Simion1z1/Sorting-robot/presentations/Presentation-Simple.pptx

ROBOTICS PROJECT

The robot that sorts boxes by their QR code

How it picks up a box, reads its code and places it on the right shelf by itself — explained simply, step by step.

QR Sorting Robot • Cartesian XYZ gantry + ESP32 • PC-decode pipeline

## Slide 2

What does the robot do?

A miniature automated warehouse: pick & place with sorting by code

• Boxes arrive, each with a QR code stuck on it
• The code says WHERE the box must go (e.g. MS0011, CJ0012)
• The robot picks up the box and reads its code with a camera
• It decides by itself which shelf it belongs to and places it there
• It returns and waits for the next box — fully automatic

## Slide 3

In short: 5 steps

1

PICK the box
from the feed zone

2

BRING the box
to the camera

3

READ
the QR code

4

DECIDE
the right shelf

5

PLACE the box
and return

## Slide 4

How the robot moves

A Cartesian XYZ frame (gantry), not an articulated arm

• It has 3 axes sliding on straight rails: X, Y and Z
– X = left/right, Y = front/back, Z = up/down
• Combining the 3, the tip reaches any point (like a 3D map)
• Same principle as a 3D printer or a CNC machine
• Stepper motors: they turn in equal steps → very precise positioning

## Slide 5

How the robot “sees” the QR code

A QR code = a “2D barcode” that hides a piece of text

• On its tip it carries a small camera (ESP32-CAM)
• The camera STREAMS the video over WiFi to a PC
• On the PC, a Python program (OpenCV) decodes the code into text
– Why on the PC? It is far more accurate than decoding on the tiny chip
• The camera is always brought to the same spot so it stays in focus

## Slide 6

The three actors of the system

THE EYE — ESP32-CAM
Sits on the tip. Streams the video over WiFi. Decodes nothing, moves nothing.

THE PC
Receives the video, decodes the QR with OpenCV, sends the code to the brain.

THE BRAIN — ESP32
Gets the code, drives the motors and the hand, decides the shelf.

Data flows one way: camera → (WiFi video) → PC → (USB cable, “QR:CJ0012”) → brain.

## Slide 7

How it decides where to put the box

Fixed code → cell mapping: simple and safe

• The shelves are a grid of 3 rows × 2 columns
• Each code has a fixed cell, set in advance:
– MS0011 → row 1 left, CJ0012 → row 2 right, etc.
• The robot looks the code up in a table and goes exactly there
• Unknown code? It rejects it — it will not risk a mistake

## Slide 8

Why ESP32 and not classic Arduino?

ESP32 = a small, cheap and powerful “mini-computer”

• It has WiFi/radio built in → needed for the wireless video
• It has far more memory → it can handle the camera image
• It has 2 cores → it moves the motors AND communicates at the same time
• It generates the motor pulses with dedicated hardware (precise)
• An Arduino Uno (2KB memory, no radio) simply could not

## Slide 9

Safety: how it does NOT hit the shelves

Simple rules that prevent collisions

• It ALWAYS raises the arm (Z) before moving sideways
• On power-up it does “homing”: it finds the zero point by itself
• It has software limits — it cannot leave the working area
• A STOP command that halts everything instantly

## Slide 10

In short — what we built

Thank you! Questions?

• An XYZ robot that sorts boxes fully automatically, by QR code
• Two ESP32 boards: one “sees”, one “drives”
• A PC decodes the code for high accuracy
• Precise motors + camera + a hand that grabs the box
• Every decision was made for reliability and simplicity
