Simion1z1/Sorting-robot/presentations/Presentation-Technical.pptx

TECHNICAL DOCUMENTATION

QR Sorting Robot — Cartesian XYZ gantry

Architecture, motion control, vision, the PC-decode pipeline, the sorting logic and the design decisions.

QR Sorting Robot • Cartesian XYZ gantry + ESP32 • PC-decode pipeline

## Slide 2

Table of contents

• 1. System architecture (two MCUs + a PC)
• 2. Mechanics: XYZ gantry + screw actuators
• 3. Motion control: steppers, A4988, FastAccelStepper
• 4. Coordinates, homing, software limits
• 5. Gripper (SG90 / LEDC PWM)
• 6. Vision: PC-decode pipeline (ESP32-CAM stream + OpenCV)
• 7. Communication (WiFi stream + USB serial)
• 8. Sorting logic (CODE_MAP) + state machine
• 9. Power & pin map
• 10. Design decisions & lessons

## Slide 3

System architecture

1

## Slide 4

Two microcontrollers + a PC, separate responsibilities

ESP32-CAM — VISION
OV2640 + PSRAM. Streams MJPEG over WiFi (esp32cam_stream). Decodes nothing, controls nothing mechanical. Rides on the Z carriage.

PC — DECODER
decode_qr.py: reads the MJPEG stream, decodes the QR with OpenCV/pyzbar, forwards “QR:<code>” over USB serial.

ESP32 WROOM-32D — BRAIN
State machine (brainPC). STEP/DIR for 3× A4988, homing on endstops, servo, receives QR over serial, decides the cell.

Why the split?
The camera takes up nearly all ESP32-CAM pins, and reliable QR decoding is heavy. The motion loop is timing-critical and must never be blocked. → camera streams, PC decodes (accurately), brain moves.

## Slide 5

Why ESP32 (not AVR/Arduino Uno)

• Built-in radio (WiFi) — mandatory for the wireless video stream
• Dual-core 240 MHz — motion on one core, comms on the other
• ~520 KB RAM (+PSRAM on the CAM) — impossible with 2 KB on an ATmega328
• Hardware peripherals: RMT (step pulses) and LEDC (servo PWM)
• 3.3 V logic — directly compatible with the ESP32-CAM, no level-shifter
– Programmed entirely from the Arduino IDE (C/C++) — same ecosystem

## Slide 6

Mechanics — XYZ gantry

2

## Slide 7

Cartesian frame with screw actuators

Advantage: precision and repeatability (like a 3D printer / CNC)

• 3 orthogonal axes: X (left/right), Y (front/back), Z (up/down)
• Each axis = screw actuator (lead/ballscrew) + NEMA 17
• Screw rotation → translation of the nut/carriage (linear motion)
– Screw lead = 4 mm per turn
• On the Z carriage: the gripper + ESP32-CAM (load below the Z motor torque)
• Typical build order: Y base → X bridge → Z vertical

## Slide 8

Motion control

3

## Slide 9

Stepper motors + A4988 drivers

• NEMA 17, 1.8°/step → 200 steps per full revolution
• Open-loop control: count the steps ⇒ you know the position
• The ESP32 cannot power the motor → the A4988 driver amplifies
– The brain only sends: STEP (pulse = 1 step) and DIR (direction)
– Shared ENABLE (GPIO13, active-LOW) for all 3 drivers
• Runs on full step; MS1/2/3 set by jumpers, not on GPIO

## Slide 10

Calibration: steps per millimeter

steps_per_mm = (steps/turn × microstepping) / screw_lead
= (200 × 1) / 4 mm = 50 steps/mm

• Verified empirically: command 100 mm → measure with calipers → 100 mm ⇒ steps_per_mm = 50.0
• FastAccelStepper: timing on the RMT hardware → no lost steps at high speed
• 3 motors at once, smooth acceleration/deceleration, without loading the CPU
• Motion profile: V (mm/s) and A (mm/s²) adjustable from commands

## Slide 11

Coordinates & homing

4

## Slide 12

Homing — establishing the origin

• At power-on the physical position is unknown → need a reference zero
• 6 endstops (MIN + MAX per axis), wired NO + INPUT_PULLUP
– Pressed = LOW (NC would be fail-safe, but the NC terminal did not work)
• Per-axis sequence: fast approach → back-off ~4 mm → slow re-approach → 0
• Order Z → X → Y (anti-collision: raise Z first)
• Z homes UP (toward MAX): the shelves are in front
– Consequence: Z=0 is at the top (safe); going down toward shelves = negative

## Slide 13

Software limits (soft limits)

Axis | Min (mm) | Max (mm) | Note
X | 0 | 194 | homes at MIN, positive travel
Y | 0 | 170 | homes at MIN, positive travel
Z | −117 | 0 | homes at MAX (top); down = negative

Safe travel
Travel height is Z = −5 mm (not 0): exactly at Z=0 the MAX switch is pressed. Before any X/Y move, Z is raised to −5 mm.

## Slide 14

Gripper

5

## Slide 15

The hand that grabs the box (SG90)

• Parallel gripper with 2 jaws, driven by an SG90 servo
• Servo = you command an angle (0–180°), it goes exactly there
• 50 Hz PWM signal on GPIO19, generated by the ESP32 LEDC peripheral
– Open = 3°, closed = 47° (at 50° it strains and buzzes)
• Needs solid dedicated 5V: at 4.5V it only “ticked”, looked broken
– Code robust to ESP32 core 2.x vs 3.x (ledcWrite/ledcAttach differ)

## Slide 16

Vision — reading the QR

6

## Slide 17

PC-decode pipeline

• The OV2640 camera captures the image (SVGA 800×600)
• ESP32-CAM serves an MJPEG stream over WiFi at http://<ip>/stream
• The PC opens the stream (OpenCV) and decodes the QR per frame
– pyzbar first, then OpenCV QRCodeDetector as fallback; errors caught
• Fixed focus (~10–20 cm): the camera is always brought to SCAN_POS
• On a hit, the PC sends “QR:<code>” to the brain over USB serial

## Slide 18

Why decode on the PC (not on the camera)

On-device problem (abandoned)
On-board decoding (quirc on the ESP32-CAM) gave a read rate often under 10%: fixed-focus OV2640 + a weak chip for image processing.

PC-decode solution
The camera only streams MJPEG; the PC decodes with OpenCV/pyzbar (far more accurate) and forwards the code to the brain. Plus a live debug window.

• esp32cam_stream.ino — MJPEG server on the camera (WiFi)
• pc/decode_qr.py — reads the stream, decodes, sends “QR:<code>” + forwards commands
• brainPC.ino — routes lines starting with “QR:” into the sort logic
• The earlier ESP-NOW on-device variant stays as a standalone fallback

## Slide 19

Communication

7

## Slide 20

Two links: camera → PC → brain

Link 1 — WiFi (MJPEG video)
ESP32-CAM joins the WiFi, runs a small web server, serves a continuous JPEG stream at /stream. The PC reads it with cv2.VideoCapture(url).

Link 2 — USB serial
The PC sends “QR:<code>” to the brain; the same cable carries the brain's logs back and the commands you type (HA, R1, P...).

• brainPC.ino: a line starting “QR:” → sort logic; otherwise → console command
• decode_qr.py auto-reconnects if the stream drops
• Anti-spam cooldown so the same code is not re-sent too fast
• The camera (streamer) needs only power — no data wire to the moving carriage

## Slide 21

Sorting & state machine

8

## Slide 22

3×2 shelves and the fixed code → cell mapping

| Column 1 | Column 2
Row 1 | MS0011 | MS0012
Row 2 | CJ0011 | CJ0012
Row 3 | EB0011 | Boxes (pickup)

• CODE_MAP: fixed table code → (row, column)
– Strategy A (fixed mapping), not “first free”
– Small, fixed set ⇒ deterministic, easy to debug
• Each cell: (x,y,z) taught manually (teach)
– Positions hardcoded in the sketch (no NVS)
• Unknown code → rejected (no move)

## Slide 23

State machine (the AUTO cycle, R1)

HOMING
Z→X→Y

GO TO
SCAN_POS

WAIT
for QR

VALIDATE
known code?

PICK
from Boxes

PLACE
at cell

RETURN
to SCAN

• Z always raised before any X/Y move (anti-collision)
• Unknown/missing code → rejected, the cycle does not get stuck
• 5 s cooldown after each sort so repeated detections do not loop the cycle
• STOP (S or R0) instantly halts motion and auto mode

## Slide 24

Power & pins

9

## Slide 25

Power distribution

• 12V → the 3 A4988 drivers (VMOT) + 100µF capacitor/driver
• Buck 12V→3.3V → ESP32 brain + driver logic
• Dedicated 5V → SG90 servo (+ cap, anti voltage-sag)
• ESP32-CAM: powered separately over USB 5V (laptop/power bank)
• COMMON GND mandatory between supply, bucks, brain, drivers, servo
– The camera (WiFi) does NOT need a common GND with the brain

Separate domains
12V power (motors) and 3.3V logic are different domains, tied only by the common GND. Capacitors absorb current spikes and prevent brownout/reset.

## Slide 26

Pin map (brain ESP32 WROOM-32D)

Function | GPIO | Notes
X STEP / DIR | 25 / 26 | pulses + direction, motor X
Y STEP / DIR | 32 / 33 | motor Y
Z STEP / DIR | 27 / 14 | motor Z
ENABLE (all 3) | 13 | active-LOW, shared
Endstop MIN X/Y/Z | 21 / 22 / 23 | INPUT_PULLUP, pressed=LOW
Endstop MAX X/Y/Z | 4 / 18 / 17 | INPUT_PULLUP
SG90 servo | 19 | PWM LEDC 50 Hz
QR input | USB serial | “QR:<code>” from the PC decoder

## Slide 27

Decisions & lessons

10

## Slide 28

Design decisions (and WHY)

• Two MCUs: isolate timing-critical motion from image handling
• ESP32 vs Arduino: radio + RAM + dual-core + hardware timing
• Decode on the PC: much higher QR read accuracy than on-device
• ESP-NOW on-device variant abandoned (read rate was the bottleneck)
• FastAccelStepper: no lost steps at speed/microstepping
• Fixed mapping (A): deterministic on a small code set
• Z homes up: avoids collision with the shelves in front
• Hardcoded positions: simple “teach & paste” flow for a prototype

## Slide 29

Problems encountered & solutions

Problem | Cause | Solution
Servo only ticked | 4.5V supply | solid dedicated 5V + common GND
Camera kept resetting | weak USB / auto-off | good USB, 470µF cap
Low on-device QR rate | fixed focus / weak chip | moved decoding to the PC
Stream read fails | WiFi hiccup | decode_qr.py auto-reconnects
Cycle looped on one box | repeated detections | 5 s cooldown after each sort
“endstop hit” on Z | Z=0 sits on the switch | travel at Z=−5 mm

## Slide 30

Conclusions

Thank you! Questions?

• XYZ gantry + steppers/A4988, driven by an ESP32 (state machine)
• ESP32-CAM as a wireless camera; the PC is the smart decoder
• Deterministic sorting via a fixed code → cell table
• Robust architecture: vision/motion split + PC-side accuracy
• Many decisions validated hands-on at the bench (power, decoding, Z homing)
