Simion1z1/Sorting-robot/Gen Qr-codes/QR Codes.pdf

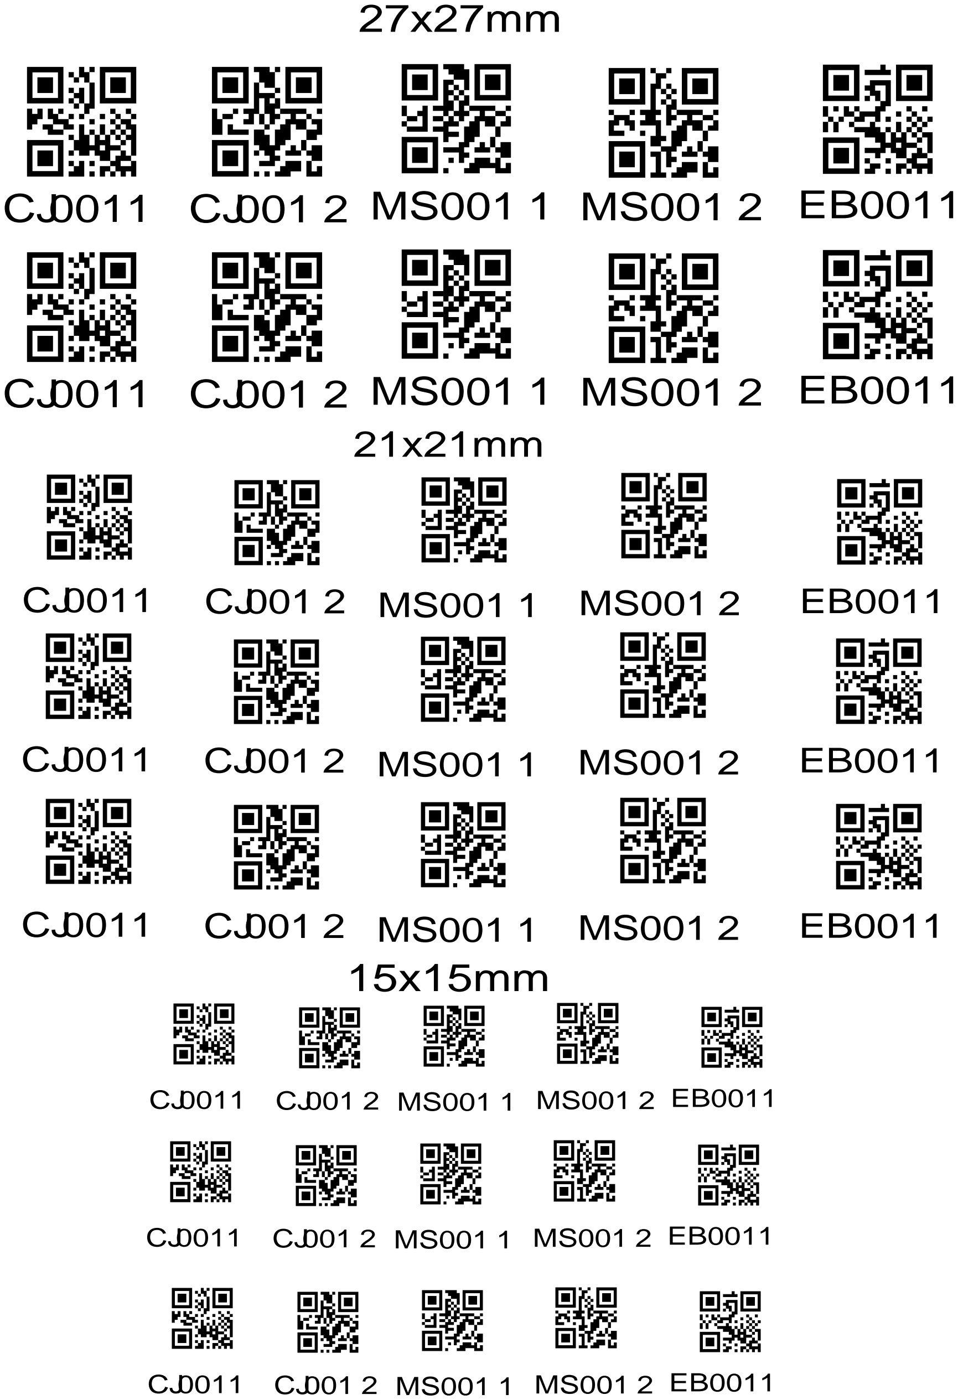
[picture p1: page 1]

CJ0011

CJ0011

CJ001 2

EB0011

CJ001 2

MS001 1

MS001 1

MS001 2

27x27mm

15x15mm

21x21mm

EB0011

CJ0011
CJ001 2

MS001 1
MS001 2

EB0011

MS001 2

CJ0011
CJ001 2
MS001 1

MS001 2

EB0011

CJ0011
CJ001 2
MS001 1

MS001 2

EB0011

CJ0011
CJ001 2
MS001 1

MS001 2

EB0011

CJ0011
CJ001 2
MS001 1

MS001 2

EB0011

CJ0011
CJ001 2
MS001 1

MS001 2

EB0011
