Simion1z1/Sorting-robot/Schematic/SCH_Sorting Robot Schematic_1-P1_2026-06-11.png

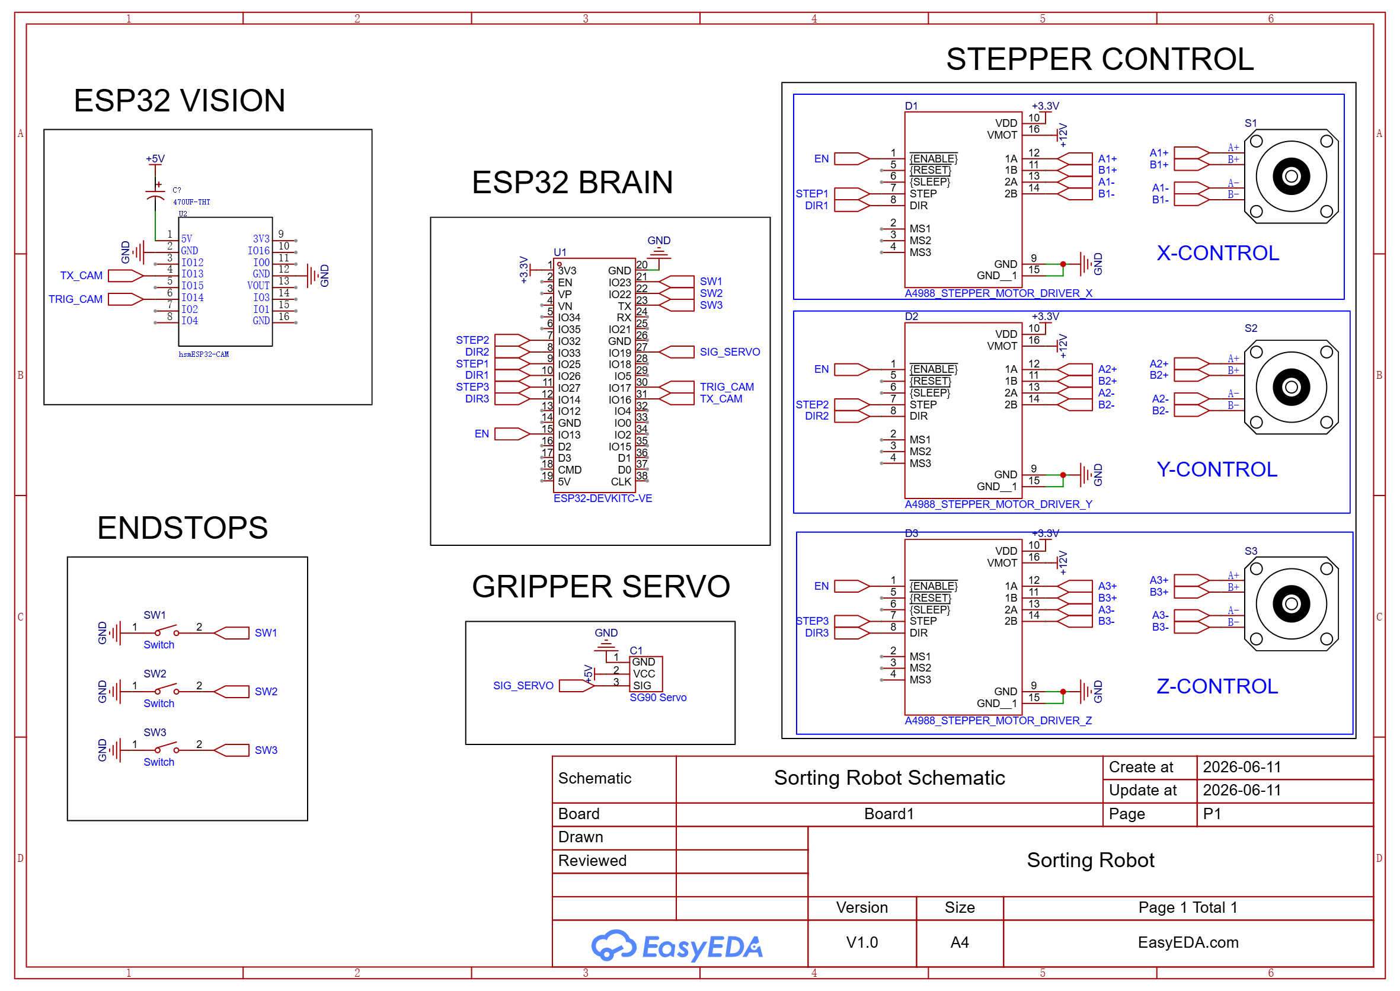
Schematic/SCH_Sorting Robot Schematic_1-P1_2026-06-11.png
