Simion1z1/Sorting-robot/SCH_Sorting Robot Schematic_2026-06-17.pdf

# STEPPER CONTROL

# ESP32 BRAIN

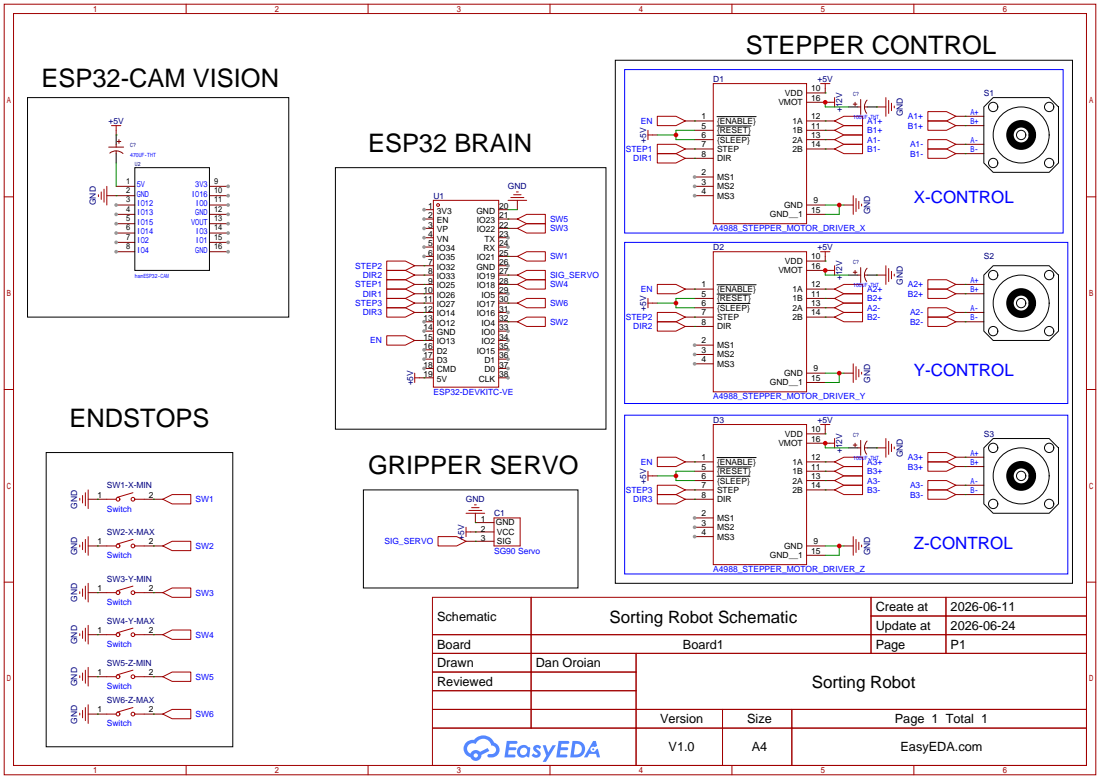
[picture p3: page 1]

GND GND GND

Schematic | Sorting Robot Schematic | Create at | 2026-06-11

Update at | 2026-06-24

Board | Board1 | Page | P1
Drawn | Dan Oroian | Sorting Robot
Reviewed

Version | Size | Page 1 Total 1
V1.0 | A4 | EasyEDA.com
