Simion1z1/Sorting-robot/docs/schema-bloc.pdf

# Robot de sortare QR — schema bloc

## PSU 12V

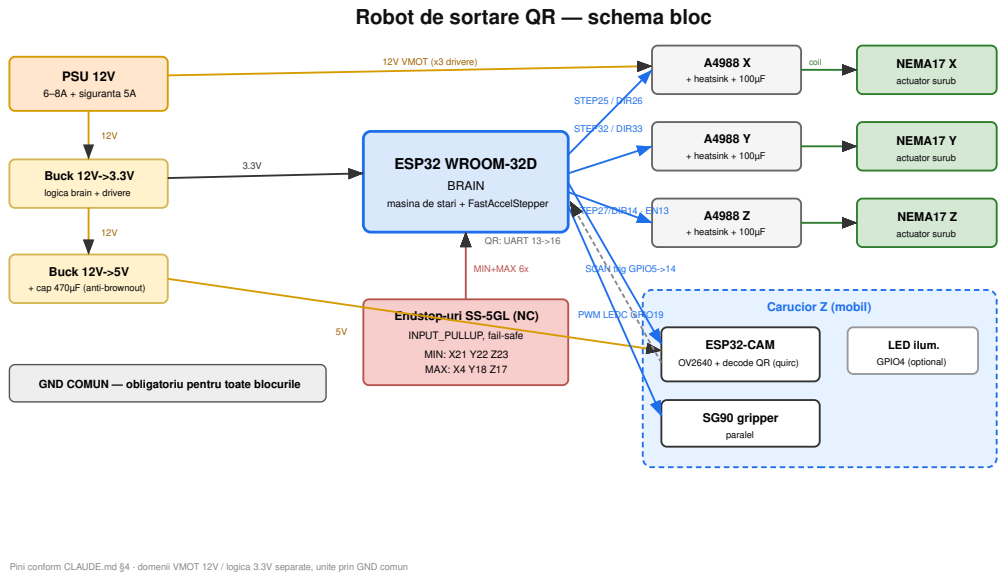
[picture p4: page 1]
6–8A + siguranta 5A; ESP32 WROOM-32D BRAIN; A4988 X + heatsink + 100µF; A4988 Y + heatsink + 100µF; A4988 Z + heatsink + 100µF; NEMA17 X actuator surub; NEMA17 Y actuator surub; NEMA17 Z actuator surub; Carucior Z (mobil); SG90 gripper paralel; LED ilum. GPIO4 (optional); 12V VMOT (x3 drivere); STEP25 / DIR26; STEP32 / DIR33; STEP27/DIR14 · EN13; coil; MIN+MAX 6x; PWM LEDC GPIO19; SCAN trig GPIO5->14; QR: UART 13->16

Buck 12V->3.3V
logica brain + drivere

masina de stari + FastAccelStepper

Buck 12V->5V
+ cap 470µF (anti-brownout)

Endstop-uri SS-5GL (NC)
INPUT_PULLUP, fail-safe
MIN: X21 Y22 Z23
MAX: X4 Y18 Z17

ESP32-CAM
OV2640 + decode QR (quirc)

GND COMUN — obligatoriu pentru toate blocurile

Pini conform CLAUDE.md §4 · domenii VMOT 12V / logica 3.3V separate, unite prin GND comun
