Simion1z1/Sorting-robot/(commit log)

2026-06-11 Added schematic and test code for esp32-cam
2026-06-16 working qr code 6x6cm with distance detection of 30 cm
2026-06-19 XYZ stepper test
2026-06-19 XYZ stepper test with limit switches and brain code started
2026-06-20 Calibration updated
2026-06-23 camera updated and plac c tests
